matryt/ProjetArduino/README.md

# Projet Arduino

## Objectif
Surveillance d’une zone, alertes (personne inconnue) et transmission d’information sur une interface  

## Cahier des charges
- Suivi et détection de personne dans un certain périmètre autour du robot
- Identification des personnes détectées (autorisés ou non) dans base de données.
- Déplacement du robot sur deux axes
- Balayage d’une zone donnée
- Caméra avec rotation sur 2 axes 
- Notifications des alertes sur une interface dédiée

## Matériel nécessaire 

- Moteurs
  - 2 moteurs de roues
  - 1 servomoteur (orientation verticale de la caméra)
- ArduCam
- Capteurs ultrasons (détection des obstacles et des murs)
- Module wifi (transmission des données)
- Armature
- Batterie / piles
