matryt/ProjetArduino/Rapports_Seance/Loïc/21_02/rapport.md

# Avant la séance :
- Ajout d'une troisième roue à l'avant du robot pour que le robot soit à l'horizontal
- Fixation des composants dans le robot avec des morceaux de plastiques 
- Ajout et cablage d'un bouton au niveau de la carte arduino 

# Pendant la séance : 
- Impression 3D d'une nouvelle roue car l'ancienne roue ne tenait plus correctement à cause du méplat qui n'était plus présent à force de tourner => collage des morceaux de joints thoriques de l'anciennes roue et montage sur le robot
- Test de déplacements du robot => le robot  tourne d'un côté ( lorsqu'il est censé aller droit ) compensation sur le pwm d'un des moteurs > OK
- Problème non résolu : au démarage le robot tourne un peu puis va en ligne droite
- testes en faisant fonctionner la carte MaixDuino et s'assurer de la bonne réception des données sur l'interface
- Teste pour savoir si la reconnaissance de visage marche correctement lorsque que le robot est en mouvement => la déctection est assez instable , l'information est bien envoyé jusqu'à l'interface web seulement l'information est souvent incorrect
