matryt/ProjetArduino/Rapports_Seance/Loïc/07_02/rapport.md

# Pendant la séance : 
- perçage de la plaque en plexiglass au centre pour la vissé à l'attache du servomoteur
    => vis d'attache trop courte à cause de l'épaisseur de la plaque en plexiglass 
    => vis seulement à travers l'attache du servo moteur puis collage de l'attache sur la plaque en plexiglass 
    - collage au pistolet à colle de la plaque en plexiglass sur la structure de la carte MaixDuino 
- perçage de la structure pour pouvoir fixer/visser le support du servo moteur => fixation et postionnement définitif du servo moteur 
- Support des moteurs : 
    - test de positionnement des moteurs => OK
    - fixation sur la structure au pistolet à colle 
-Ajout d'un morceau de PVC ( fixation au pistolet à colle ) sous la structure ( rôle de troisème roue) pour le bon déplacement du robot et éviter le plus possibles les frottements 
- Positionnement dans la structure et cablage des composants pour la structure au propre 
# Prochaine Séance : 
- Ajout de joints thoriques aux deux roues pour l'adhérence 
- Ajout/cablage d'un capteur de distance   
- Début des tests
