matryt/ProjetArduino/Rapports_Seance/Loïc/24_01/rapport.md

# Avant la séance :
- Assemblage de la structure avec Mathieu :   
	-  plaques en bois découpé au laser pour les différents étages de la structure et avec des perçage 3mm(M3)
	- ajouts entretoises et tiges filetées ( découpe et ponçage ) et des boulons
# Pendant la séance : 
- Pièce de fixation du servo moteur sur la structure 
	- Prise de mesure du servomoteur et modélisation sur Onshape avec perçage pour la fixation avec des vis sur la structure
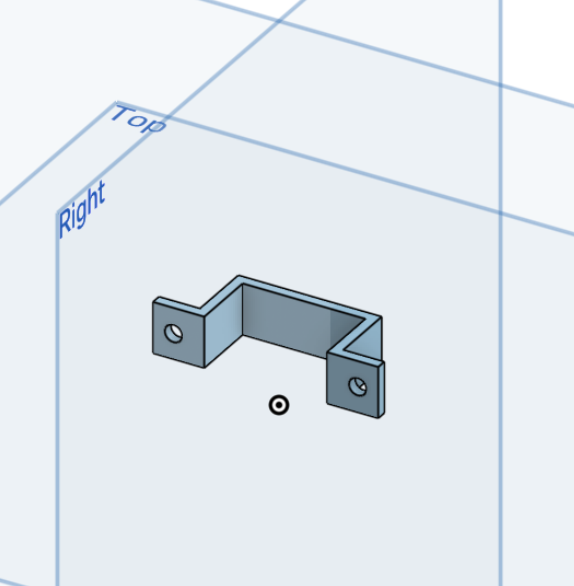
[picture p2: Rapports_Seance/Loïc/24_01/fixationservomoteur.jpeg.png]
Texte alternatif Le titre de mon image
		 
	- Impression 3D au FabLab 
	- Test de la pièce 3D de fixation sur le servo moteur et la structure => OK (2)
- Réflexion pour la fixation de la plaque en plexiglass servant de support pour fixer le servomoteur à la carte MaixDuino (1)

# Prochaine Séance : 
- (1) => perçage de la plaque en plexiglass au centre pour la vissé à l'attache du servomoteur
- (2) => perçage de plaque supérieur de la structure pour pouvoir visser la fixation du servomoteur  
- (2) =>  colle/glue entre  la struture de la carte MaixDuino et la plaque en plexiglass
