matryt/ProjetArduino/Rapports_Seance/Mathieu/17_01/document.md

# Avant la séance

- Organisation et nettoyage du Github

- Création et organisation de la base de données pour l'historique

- Début de la page d'historique

# Pendant la séance

- Avancement de la page d'historique

- Gestion de la base de données dans le script Flask

- Assemblage d'un montage avec Loïc pour tester la consommation des deux cartes ainsi que des moteurs

- Dessin des plaques de la structure à partir du modèle 3D existant dans des fichiers séparés pour la découpe laser du bois

- Recherches sur les alimentations possibles après mesure des consommations par Loïc

- Réflexion sur les possibilités d'assemblage des différentes plaques
