matryt/ProjetArduino/Rapports_Seance/Loïc/17_01/rapport.md

# Séance 
- Impression 3D de deux roues pour les deux moteurs pour le robots et pour tester la consommation en simulation fonctionnement
- Modification du montage (pont en H ,Moteurs,...) pour passer de deux câblage d'alimentation à une seule :
	Ajout d'un jumper sur le pont en H pour passer l'entrée +5V de la partie commande à sortie +5V pour alimenter la carte arduino 
		pour donc garder seulement l'alimentation du pont en H 
- Montage avec l'alimentation du labo pour mesure du courant consommé : 
	- pour la carte MaixDuino dans un premier temps
	- pour les deux moteurs + servo-moteur + pont en H + carte arduino dans un deuxième temps
-->  consomation total d'environ 650 mA  ( 400 mA (MaixDuino) + 250 mA (seconde carte ))
