matryt/ProjetArduino/Rapports_Seance/Loïc/10_01/rapport.md

# Avant séance
- Discussion avec Mathieu sur les capacités d'envoi de la carte suite à ses tests : en effet, celle-ci rame énormément lorsqu'il s'agit d'envoyer un flux vidéo permanent et ne capture quasiment plus les visages => Décision est prise d'envoyer uniquement les visages détectés et non un flux permanent
- Travail de l'interface d'alerte et de notification avec Mathieu
- Discussion avec Mathieu sur les problèmes réseau de la carte : l'envoi des images prend plusieurs secondes pendant lesquelles la caméra ne capture plus rien => Recherche de solutions pour garder de la fluidité dans l'utilisation de la caméra

# Pendant la séance 
- Modification de la structure du robot à imprimer après s'être assuré que la MaixDuino était effectivement utilisée
- Recherche sur les possibilités d'alimentation du robot (notamment pile NiMH) : deux piles , support , chargeur 
- Reflexion sur les possibilités de fixation du servo-moteur : fixation avec un support sur la carte et sur la structure pour l'orientation vertical de la caméra
