matryt/ProjetArduino/Rapports_Seance/Loïc/20_12/rapport.md

# Préparation avant séance 
- Recherche  et documentation sur le pont en H HW-95 ( alimentation possible )
- Test de fonctionnement du pont en H avec un moteur 

# Séance 
- Finalisation du montage des deux moteurs avec le pont en H :
	- Cablage du deuxième monteur ( soudure de deux fils )
    - Test avec deux moteurs => les deux moteurs ne tourne pas à la même vitesse 
    - Changement de moteurs , nouveau test concluant 
- Ajout du Servo Moteur 
 - Cablage du servo moteur SG90
 - Premier programme de test ( concluant ) 
 - Test avec le pont en H et les deux moteurs ( concluant )
- Test module wifi avec l'arducam avec le Webserver
  - => Module non suffisant pour transmettre l'image de l'arducam
- Nouveau test avec en partage connexion avec notre téléphone
  - accès à l'interface avec le retour vidéo
  - Test de la reconnaissance de visage
  - On se rend compte que l'arducam ne permet l'enregistrement de visage

- Changement de carte ( ArduCam -> Optical flow sensor ( non adapté qualité trop faible  )  jusqu'à la MaixDuino 

# Objectif avant prochaine Séance :
- Savoir si la carte MaixDuino est adapté à notre projet et avancer sur la modélisation de la structure
