matryt/ProjetArduino/Rapports_Seance/Mathieu/13_12/document.md

# Tâches effectuées : 
- Configuration des pilotes et des libraires externes pour utiliser ArduCam avec l'Arduino IDE
- Discussion avec Loic concernant la réalisation du support du robot
- Recherche d'informations concernant le fonctionnement des moteurs
- Test de capture d'images statiques puis webserver temps réel
