matryt/ProjetArduino/Documentation/Présentation_projet.pdf

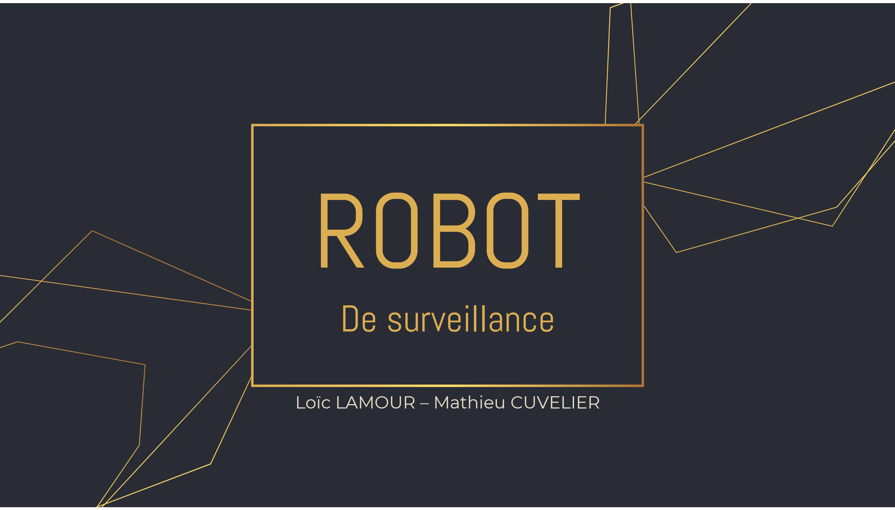
[picture p8: page 1]

Loïc LAMOUR – Mathieu CUVELIER

# ROBOT

# De surveillance

## SOMMAIRE

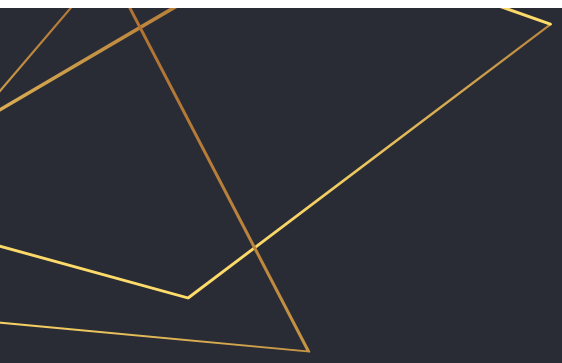
[picture p9: figure]

Présentation du projet

1.

Schéma et
fonctionnements

2.

Matériel

3.

Planning et répartition du travail

4.

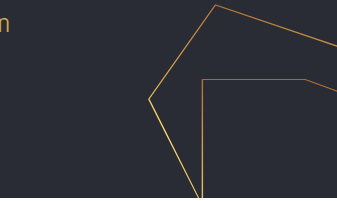
[picture p10: figure]

Conclusion

5.

## PRÉSENTATION PROJET

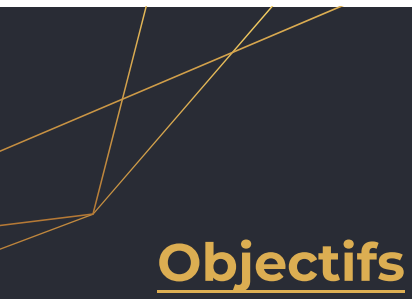
[picture p11: figure]
Objectifs

- | Suivi ( | ) et détection (

) de personnes dans un certain périmètre dans le champ de vision du robot

- Identification des personnes détectées (autorisées ou non) à partir d’une base de données (
)
- | Déplacement du robot sur deux axes ( | )
- | Balayage d’une zone donnée ( | )
- | Caméra avec rotation sur 2 axes ( | )
- | Notifications des alertes sur une interface dédiée ( | )

Cahier des charges

## SCHEMA ET FONCTIONNEMENT

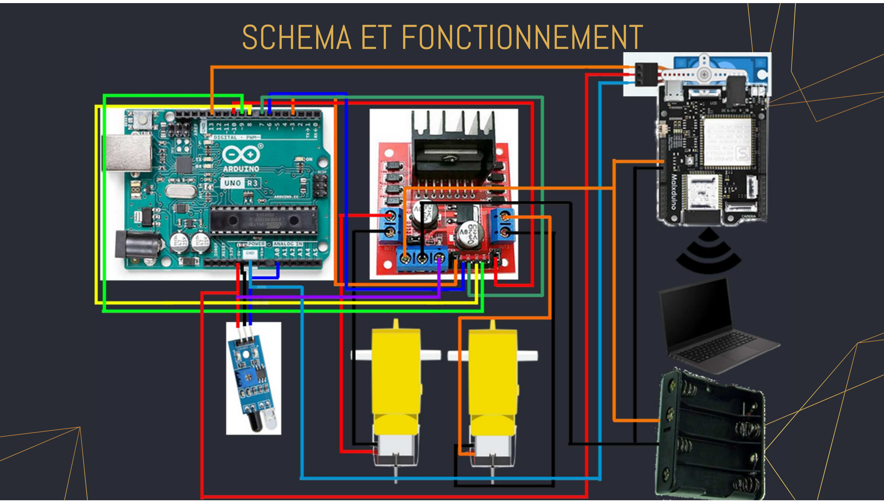
[picture p12: page 4]

## SCHEMA ET FONCTIONNEMENT (SUITE)

- Arduino : (Loïc)
- Gestion des moteurs et du déplacement du robot
- Alimentation de tous les modules (avec pont en H)
- Balayage du servomoteur pour augmenter la probabilité de capturer des visages
- MaixDuino (Mathieu)
- Enregistrement de visages de référence
- Capture d’images et comparaison
- Envoi des informations utiles à l’ordinateur

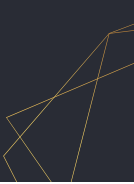
[picture p13: figure]

- Ordinateur (Mathieu + Loïc)
- Routeur pour la MaixDuino
- Réception et traitement des informations
- Affichage de l’interface

## MATÉRIEL

Carte MAIXDUINO 1.

2. MOTEURS
3. PONT EN H

SERVO MOTEUR 4.

5. Capteur de DISTANCE IR
6. Carte ARDUINO

## PLANNING ET REPARTITION DU TRAVAIL

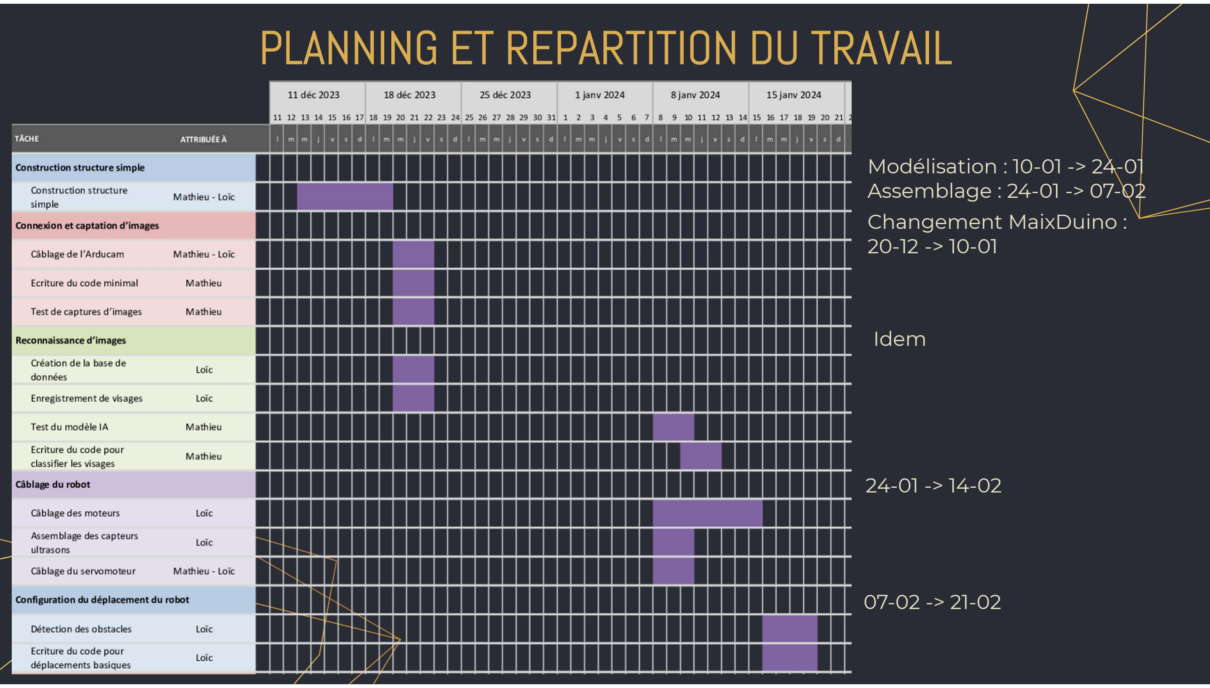
[picture p14: page 7]

Modélisation : 10-01 -> 24-01 Assemblage : 24-01 -> 07-02 Changement MaixDuino :
20-12 -> 10-01

Idem

24-01 -> 14-02

07-02 -> 21-02

## PLANNING ET REPARTITION DU TRAVAIL (SUITE)

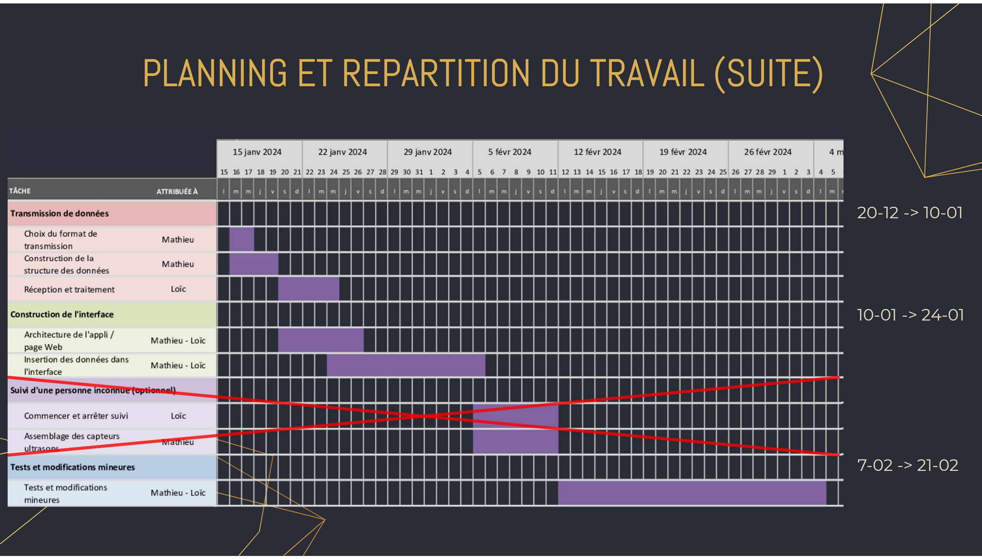
[picture p15: page 8]

10-01 -> 24-01

20-12 -> 10-01

7-02 -> 21-02

## CONCLUSION ET PERSPECTIVES

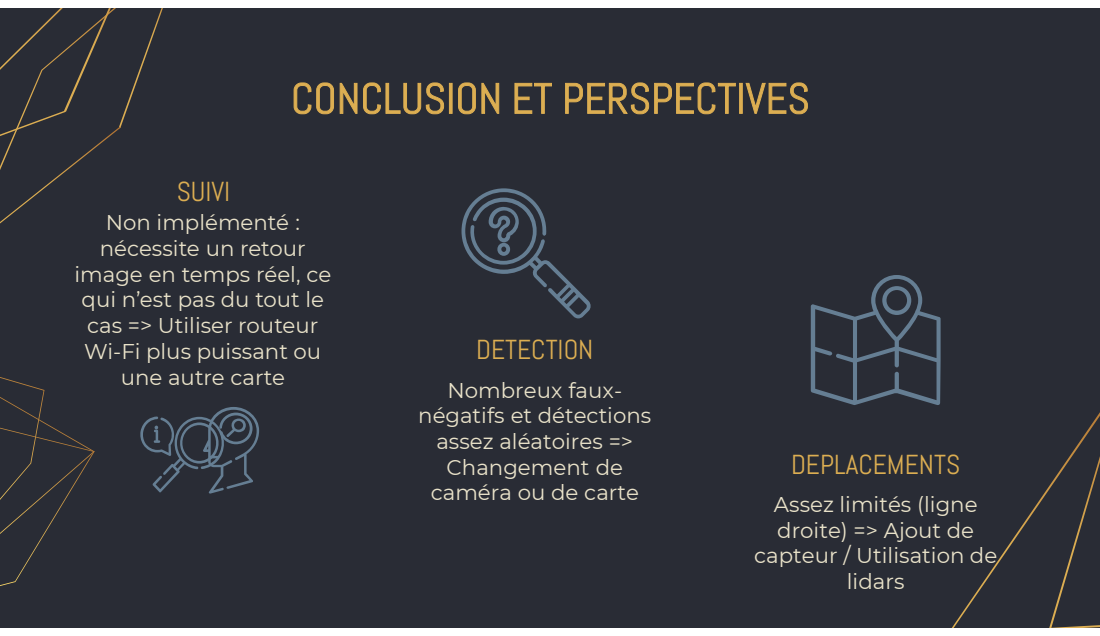
[picture p16: page 9]
SUIVI; lidars; DETECTION; DEPLACEMENTS

Non implémenté :
nécessite un retour
image en temps réel, ce
qui n’est pas du tout le
cas => Utiliser routeur
Wi-Fi plus puissant ou
une autre carte

Nombreux faux-
négatifs et détections
assez aléatoires =>
Changement de
caméra ou de carte

Assez limités (ligne
droite) => Ajout de
capteur / Utilisation de
