matryt/ProjetArduino/Rapports_Seance/Mathieu/21_02/document.md

# Avant la séance

- Ajout d'un bouton pour ajouter ou désactiver le rechargement automatique sur la page des alertes

# Pendant la séance

- Tests du fonctionnement (déplacement et capture) et ajustement de quelques comportements
