matryt/ProjetArduino/Rapports_Seance/Loïc/13_12/rapport.md

# Tâches effectuées :

- Test/vérification des deux moteurs

- Réflexion sur le positionnement des composants dans la structure

- Début de la modélisation 3D sur Onshape de la structure du robot

- Début du Cablage et test des deux moteurs avec le pont H
