matryt/ProjetArduino/Documentation/Algorigrammes/MaixDuino/MaixDuino.drawio.png

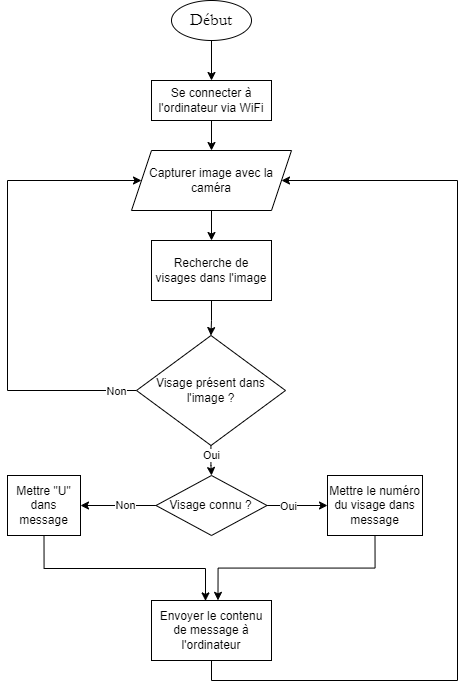
Documentation/Algorigrammes/MaixDuino/MaixDuino.drawio.png
