matryt/ProjetArduino/src/modules/ARDUINO/Servomoteur/servomoteur.cpp

// Servomoteur.cpp
#include <Arduino.h>
#include "Servomoteur.h"
#include <Servo.h>
#include "../constants.h"

Servo servo;

void Servomoteur::init() {
    servo.attach(PINS::SERVO);
    cpt = 0;
    max = (SERVO::MAX_ANGLE - SERVO::MIN_ANGLE) * 2 / SERVO::INCREMENT;
    write_angle(SERVO::MIN_ANGLE);
}

void Servomoteur::write_angle(int angle) {
    Serial.println(angle);
    servo.write(angle);
}

void Servomoteur::next() {
    int angle;
    cpt = cpt % 140;
    if (cpt >= max/2) {
        angle = (max - cpt) * SERVO::INCREMENT;
    }
    else {
        angle = cpt * SERVO::INCREMENT;
    }
    write_angle(SERVO::MIN_ANGLE + angle);
    cpt++;
}
