matryt/ProjetArduino/Projet.ino

#include "src/modules/ARDUINO/Capteur/Infrared.h"
#include "src/modules/ARDUINO/Robot/Robot.h"
#include "src/modules/ARDUINO/Bouton/Bouton.h"
#include "src/modules/ARDUINO/constants.h"

Infrared capteur;
Robot robot;
Bouton bouton;

void setup() {
  // put your setup code here, to run once:
  capteur.init();
  bouton.init(PINS::BOUTON);
  Serial.begin(9600);
  robot.init();
  bouton.waitUntilPressed();
  robot.main();
}

void loop() {
}
