matryt/ProjetArduino/(commit log)

2023-11-23 Dossier rapports de séance
2023-12-13 Création rapport de séance
2023-12-21 Servo Moteur
2023-12-28 WebServer socket MaixDuino
2023-12-29 Envoi images socket
2023-12-30 Trying to solve problem of sockets
    [network_esp32.py, send_example_sockets.py, untitled_1.py]
2024-01-18 modif code servo
2024-01-22 Modifications socketio
2024-02-06 Test capacités merge
2024-02-07 Constantes servomoteur, écriture code robot et création d'un programme de test
2024-02-08 Calibration infrarouge + rapport séance
2024-02-08 Ajout mesures infrarouge
    [Mesures.xlsx]
2024-02-10 Changement servo + ajout constantes
2024-02-10 Changement servo
2024-02-13 Code bouton poussoir
    [Mesures.xlsx]
